EduCardBoden/GameboyPi/bestellung/Warenkoerbe.md

# Warenkörbe – Stand 11.11.2026, 21:20 (DigiKey geändert)

Direkt aus den Warenkörben ausgelesen (angemeldet als du). **Bestellt ist nichts.** Word-Fassung: `Dokumente/Emulator/GameboyPi_Warenkoerbe.docx` (erzeugt von `tools/make_cart_list.py`). Pro Shop gibt es **einen Link**, der alle Artikel zusammen öffnet.

## 1. Amazon – 7 Artikel im Warenkorb, 63,01 €

**Link:** https://www.amazon.de/gp/cart/view.html (dein Warenkorb, die Artikel liegen schon drin)

| Artikel | Wofür | Preis |
|---|---|---|
| LAFVIN 2,4" TFT ILI9341 SPI mit Touch | Display | 16,13 € |
| Verbatim Premium microSDHC 32 GB | System | 12,14 € |
| GeeekPi 220-tlg. M2,5-Set (11-mm-Bolzen) | Pi befestigen | 12,10 € |
| Ewwtrey 260-tlg. M3-Nylon-Set | Display befestigen | 7,04 € |
| Kozelo 30 × M2,5 × 20 Zylinderschrauben | Gehäuse | 4,63 € |
| BOBOZHONG Kapton-Band 10 mm × 33 m | Akku isolieren | 4,73 € |
| sourcing map Schaumband 5 mm × 1 mm | Polster Display | 6,24 € |
| **Summe Warenkorb** | | **63,01 €** |

Unter „Für später gespeichert“ (nicht in der Summe, im Warenkorb unten mit „In den Einkaufswagen“ zurückholen):

| Artikel | Preis | Hinweis |
|---|---|---|
| 2er-Set LiPo 103450 2000 mAh, JST 2,0 | 13,90 € | **derzeit nicht auf Lager** |
| Litzen-Set 0,14 mm², 10 Farben | 16,39 € | auf Lager |

Mit beiden: 93,30 €.

## 2. DigiKey – 23 Positionen, 51,84 € + 25,00 € Versand = 76,84 €

**Link (Kopie des Warenkorbs, öffnet alle 23 Teile):** https://www.digikey.at/short/f3b0w9n4
Dein eigener Warenkorb: https://www.digikey.at/ordering/shoppingcart

| Pos | Teil | Herstellernr. | Menge | Preis |
|---|---|---|---|---|
| 1 | ADS1115 ADC (Adafruit) | 1085 | 1 | 13,13 € |
| 2 | Schiebeschalter | OS102011MA1QN1 | 1 | 0,66 € |
| 3 | Klinkenbuchse 3,5 mm | SJ1-3525N | 1 | 1,08 € |
| 4 | Poti 10 k log | PTV09A-2020F-A103 | 1 | 1,08 € |
| 5 | Taster 6 × 6 × 5 | B3F-1020 | 10 | 3,20 € |
| 6 | MOSFET | BS170 | 3 | 1,20 € |
| 7 | Lautsprecher 20 mm 8 Ω | AS02008MR-5-R | 1 | 3,22 € |
| 8 | Buchsenleiste 2 × 20 | PPTC202LFBN-RC | 1 | 1,88 € |
| 9 | Stiftleiste 1 × 3 | PRPC003SAAN-RC | 1 | 0,09 € |
| 10 | Widerstand 1 k | MFR-25FBF52-1K | 2 | 0,18 € |
| 11 | Widerstand 270 Ω | MFR-25FBF52-270R | 3 | 0,27 € |
| 12 | Widerstand 150 Ω | MFR-25FBF52-150R | 3 | 0,27 € |
| 13 | Widerstand 1 M | MFR-25FBF52-1M | 2 | 0,18 € |
| 14 | PowerBoost 1000C (Adafruit) | 2465 | 1 | 17,52 € |
| 15 | PAM8302 Verstärker (Adafruit) | 2130 | 1 | 3,47 € |
| 16 | Schottky-Diode | BAT85S-TAP | 2 | 0,88 € |
| 17 | Kondensator 33 nF | K333K15X7RF5TL2 | 3 | 0,78 € |
| 18 | Kondensator 100 nF | K104K15X7RF5TL2 | 2 | 0,54 € |
| 19 | Widerstand 100 k | MFR-25FBF52-100K | 10 | 0,37 € |
| 20 | Elko 100 µF 10 V | ECE-A1AKS101 | 3 | 0,96 € |
| 21 | Elko 470 µF 10 V | 10YXJ470M6.3X11 | 1 | 0,30 € |
| 22 | LED rot 3 mm | LTL-4221N | 2 | 0,34 € |
| 23 | Widerstand 47 kΩ 5 % (R6/R7, neu) | Stackpole CF14JT47K0 | 10 | 0,24 € |
| | **Zwischensumme** | | | **51,84 €** |

- **Geändert 11.11.2026:** 10 kΩ entfernt (v1.2 braucht sie nicht mehr), 47 kΩ ergänzt. Der Yageo MFR-25FBF52-47K wäre erst ab 17.03.2027 lieferbar, deshalb der sofort lieferbare Stackpole CF14JT47K0 (5 %, 2,3 × 6,0 mm). 10 Stück (0,24 €) sind billiger als 4 (0,36 €).
- Pos. 22 (LED) hat Lieferrückstand, laut DigiKey wieder lagernd am 16.11.2026.
- Ab 75 € Warenwert ist der Versand gratis, dir fehlen 23,16 €.
- Der geteilte Link zeigt den Stand von heute. Spätere Änderungen am Warenkorb übernimmt er nicht.

## 3. JLCPCB – Platine

Nicht auslesbar: Im Browser bist du bei JLCPCB nicht angemeldet, dort steht „Shopping Cart 0“. Am 21.10. lag die Platine für **10,40 $** im Warenkorb, aber das war noch die **v1.1**.
**Link:** https://cart.jlcpcb.com/quote → `bestellung/1_platine_JLCPCB/GameboyPi_Gerber.zip` (v1.2) neu hochladen.

## Noch in keinem Warenkorb

- **Raspberry Pi Zero 2 WH**: überall knapp (siehe `documentation/PURCHASING_COMPARISON.md`)
- 3D-Druck des Gehäuses

## Gesamt (ohne Pi, Platine, 3D-Druck)

| Shop | Betrag |
|---|---|
| Amazon (Warenkorb) | 63,01 € |
| Amazon (gemerkt: Akku + Litze) | 30,29 € |
| DigiKey inkl. Versand | 76,84 € |
| **Summe** | **170,14 €** |
