EduCardBoden/GameboyPi/mechanical/previews/back_outside.png

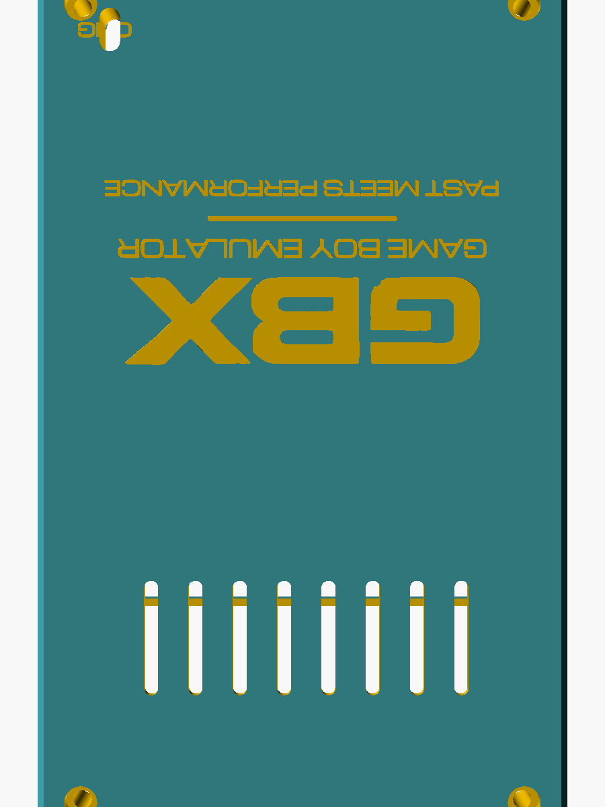
mechanical/previews/back_outside.png
