EduCardBoden/GameboyPi/electronics/assembly/GameboyPi_bom_kicad.csv

Reference | Value | Footprint | QUANTITY
C1 | 470uF 10V 10YXJ470M6.3X11 | Capacitor_THT:CP_Radial_D6.3mm_P2.50mm | 1
C2,C4 | 33nF | Capacitor_THT:C_Disc_D3.0mm_W1.6mm_P2.50mm | 2
C3,C5 | 100uF 10V ECE-A1AKS101 | Capacitor_THT:CP_Radial_D6.3mm_P2.50mm | 2
C6 | 100nF | Capacitor_THT:C_Disc_D3.0mm_W1.6mm_P2.50mm | 1
D1 | LED rot 3mm | LED_THT:LED_D3.0mm | 1
D2 | BAT85 | Diode_THT:D_DO-35_SOD27_P7.62mm_Horizontal | 1
J1 | Raspberry Pi Zero 2 W | Module:Raspberry_Pi_Zero_Socketed_THT_FaceDown_MountingHoles | 1
J2 | LCD 2.4in ILI9341 SPI (MSP2401) | Connector_PinHeader_2.54mm:PinHeader_1x14_P2.54mm_Vertical | 1
J3 | Adafruit PAM8302 | Connector_PinHeader_2.54mm:PinHeader_1x05_P2.54mm_Vertical | 1
J7 | SJ1-3525N | Connector_Audio:Jack_3.5mm_CUI_SJ1-3525N_Horizontal | 1
J8 | UART Debug (GND TX RX) | Connector_PinHeader_2.54mm:PinHeader_1x03_P2.54mm_Vertical | 1
J10 | Adafruit PowerBoost 1000C | Connector_PinHeader_2.54mm:PinHeader_1x08_P2.54mm_Vertical | 1
J11 | ADS1115 JP2 (VCC..ALERT) | Connector_PinHeader_2.54mm:PinHeader_1x06_P2.54mm_Vertical | 1
J12 | ADS1115 JP1 (AVDD..AGND) | Connector_PinHeader_2.54mm:PinHeader_1x06_P2.54mm_Vertical | 1
Q1,Q2 | BS170 | Package_TO_SOT_THT:TO-92_Inline_Wide | 2
R1 | 1k | Resistor_THT:R_Axial_DIN0207_L6.3mm_D2.5mm_P7.62mm_Horizontal | 1
R2,R4 | 270 | Resistor_THT:R_Axial_DIN0207_L6.3mm_D2.5mm_P7.62mm_Horizontal | 2
R3,R5 | 150 | Resistor_THT:R_Axial_DIN0207_L6.3mm_D2.5mm_P7.62mm_Horizontal | 2
R6,R7 | 47k | Resistor_THT:R_Axial_DIN0207_L6.3mm_D2.5mm_P7.62mm_Horizontal | 2
R8 | 1M | Resistor_THT:R_Axial_DIN0207_L6.3mm_D2.5mm_P7.62mm_Horizontal | 1
R9-R12 | 100k | Resistor_THT:R_Axial_DIN0207_L6.3mm_D2.5mm_P7.62mm_Horizontal | 4
RV1 | PTV09A-2020F-A103 10k log | Potentiometer_THT:Potentiometer_Bourns_PTV09A-2_Single_Horizontal | 1
SW1 | UP | Button_Switch_THT:SW_PUSH_6mm | 1
SW2 | DOWN | Button_Switch_THT:SW_PUSH_6mm | 1
SW3 | LEFT | Button_Switch_THT:SW_PUSH_6mm | 1
SW4 | RIGHT | Button_Switch_THT:SW_PUSH_6mm | 1
SW5 | A | Button_Switch_THT:SW_PUSH_6mm | 1
SW6 | B | Button_Switch_THT:SW_PUSH_6mm | 1
SW7 | SELECT | Button_Switch_THT:SW_PUSH_6mm | 1
SW8 | START | Button_Switch_THT:SW_PUSH_6mm | 1
SW9 | POWER | Button_Switch_THT:SW_Slide_SPDT_Angled_CK_OS102011MA1Q | 1
TP1 | VBAT | TestPoint:TestPoint_THTPad_D1.5mm_Drill0.7mm | 1
TP2 | +5V | TestPoint:TestPoint_THTPad_D1.5mm_Drill0.7mm | 1
TP3 | +3V3 | TestPoint:TestPoint_THTPad_D1.5mm_Drill0.7mm | 1
TP4 | GND | TestPoint:TestPoint_THTPad_D1.5mm_Drill0.7mm | 1
TP5 | PB_EN | TestPoint:TestPoint_THTPad_D1.5mm_Drill0.7mm | 1
TP6 | AMP_IN | TestPoint:TestPoint_THTPad_D1.5mm_Drill0.7mm | 1
