EduCardBoden/GameboyPi/bestellung/3_3d_druck/startselect.stl

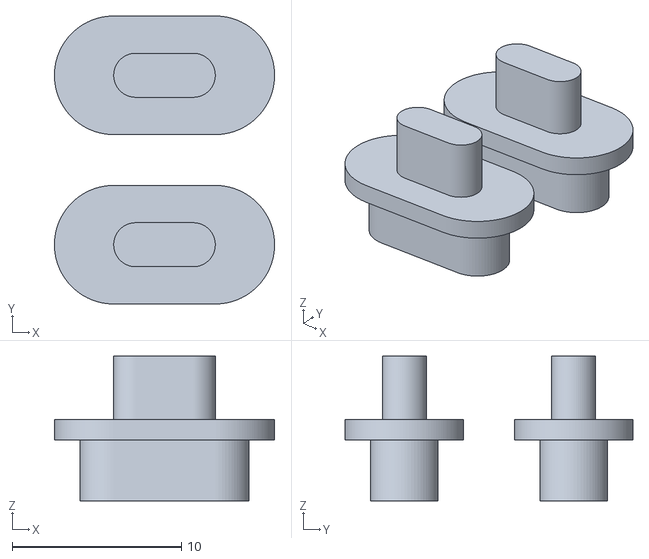
[picture p9: CAD file, 2026-10-29]
bestellung/3_3d_druck/startselect.stl
13.0 x 17.0 x 8.53
