EduCardBoden/GameboyPi/electronics/assembly/GameboyPi.step

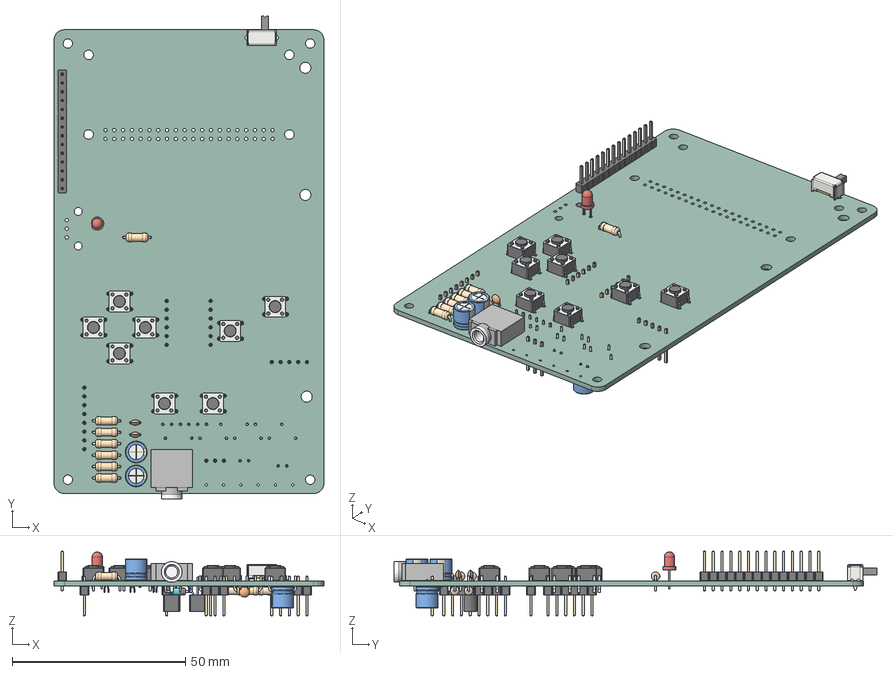
[picture p10: CAD file, 2026-11-11]
electronics/assembly/GameboyPi.step
78.0 x 139.4 x 18.8 mm
SW_PUSH_6mm x 8
R_Axial_DIN0207_L63mm_D25mm_P762mm_Horizontal x 12
Jack_3.5mm_CUI_SJ1-3525N_Horizontal
LED_D3.0mm
CP_Radial_D63mm_P250mm x 3
C_Disc_D30mm_W16mm_P250mm x 3
PinHeader_1x14_P254mm_Vertical
SW_Slide_SPDT_Angled_CK_OS102011MA1Q
PinHeader_1x06_P254mm_Vertical x 2
D_DO-35_SOD27_P7.62mm_Horizontal
PinHeader_1x08_P254mm_Vertical
PinHeader_1x03_P254mm_Vertical
TO-92_Inline_Wide x 2
PinHeader_1x05_P254mm_Vertical
GameboyPi_PCB
