EduCardBoden/GameboyPi/mechanical/stl/back_logo_silver.stl

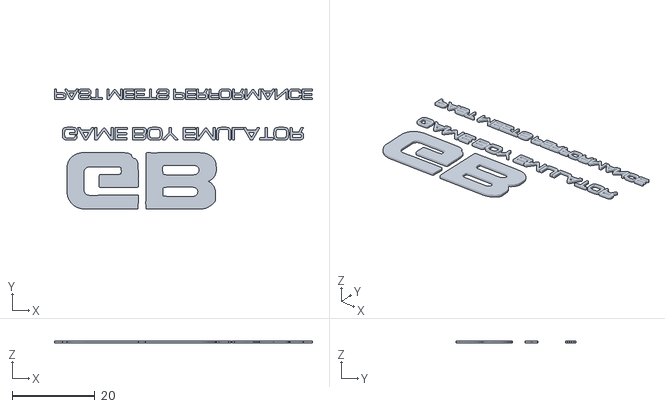
[picture p11: CAD file, 2026-10-29]
mechanical/stl/back_logo_silver.stl
62.2 x 29.0 x 0.6
