EduCardBoden/GameboyPi/mechanical/stl/front_logo_silver.stl

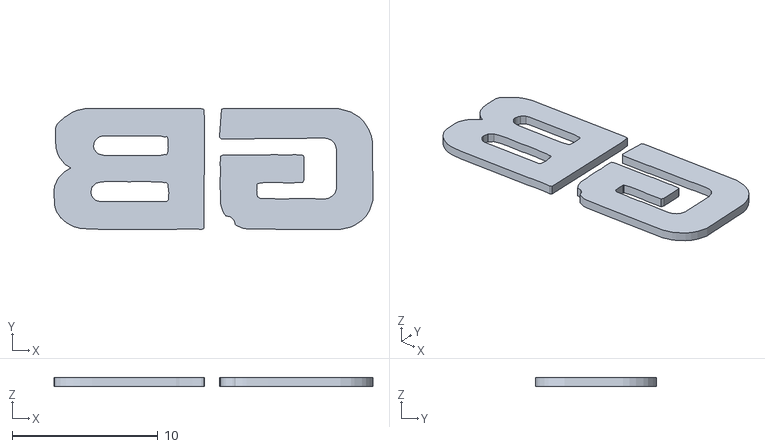
[picture p12: CAD file, 2026-10-29]
mechanical/stl/front_logo_silver.stl
21.9 x 8.30 x 0.6
