EduCardBoden/GameboyPi/bestellung/3_3d_druck/knob.stl

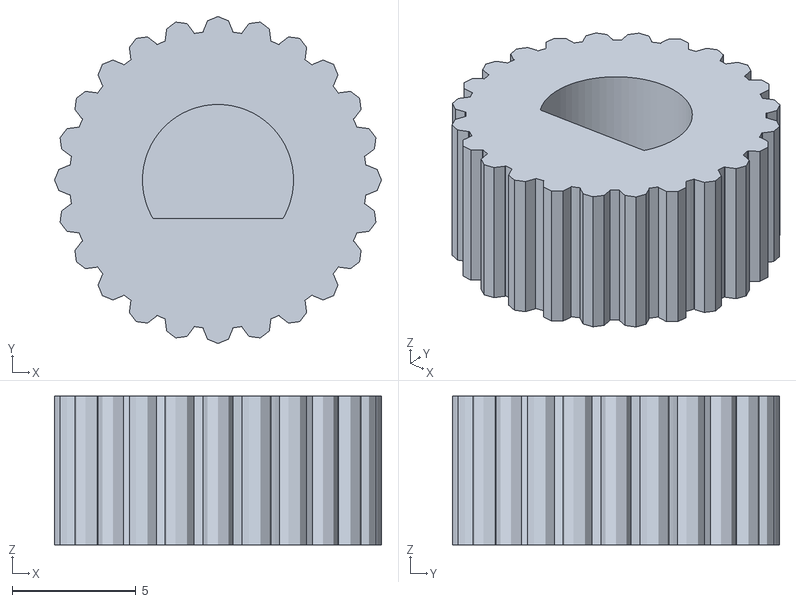
[picture p13: CAD file, 2026-10-29]
bestellung/3_3d_druck/knob.stl
13.2 x 13.2 x 6.00
