EduCardBoden/GameboyPi/bestellung/3_3d_druck/front_logo_purple.stl

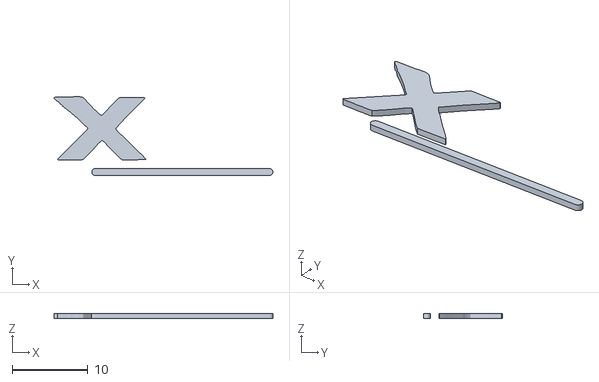
[picture p14: CAD file, 2026-10-29]
bestellung/3_3d_druck/front_logo_purple.stl
29.0 x 10.4 x 0.6
