EduCardBoden/GameboyPi/mechanical/stl/spacers.stl

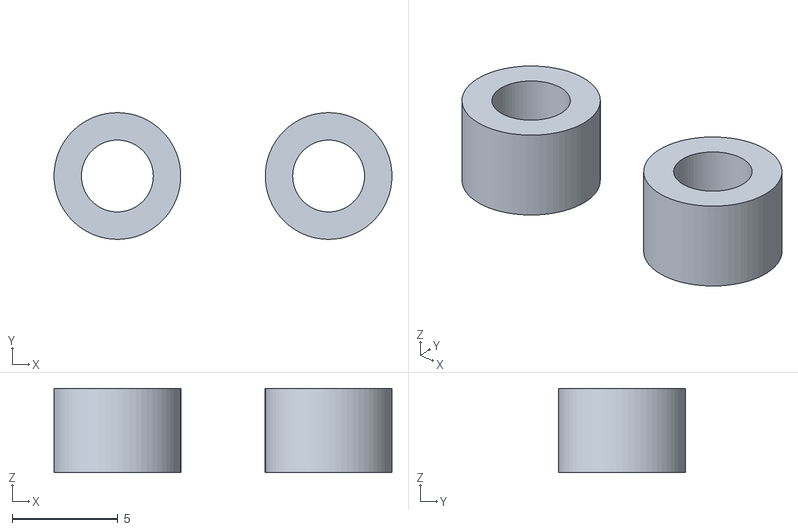
[picture p15: CAD file, 2026-10-29]
mechanical/stl/spacers.stl
16.0 x 6.00 x 4.00
