EduCardBoden/GameboyPi/bestellung/3_3d_druck/back_logo_purple.stl

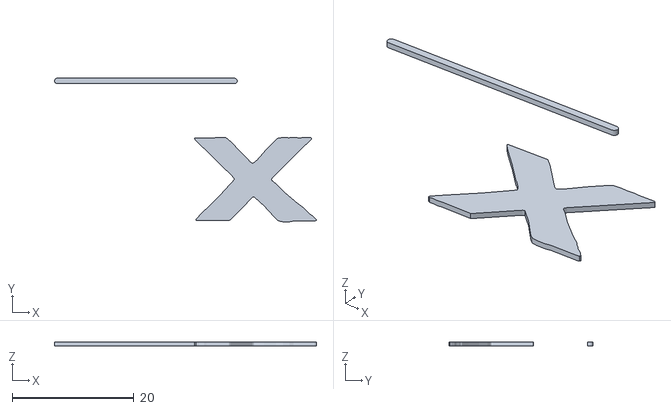
[picture p16: CAD file, 2026-10-29]
bestellung/3_3d_druck/back_logo_purple.stl
43.0 x 23.6 x 0.6
