EduCardBoden/GameboyPi/mechanical/stl/dpad.stl

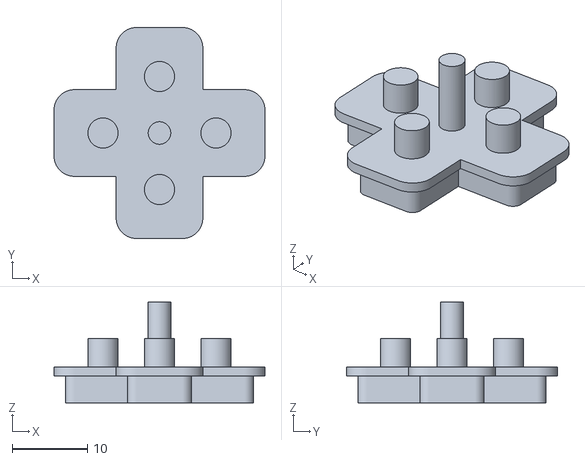
[picture p17: CAD file, 2026-10-29]
mechanical/stl/dpad.stl
28.0 x 28.0 x 13.4
