EduCardBoden/GameboyPi/bestellung/3_3d_druck/front.stl

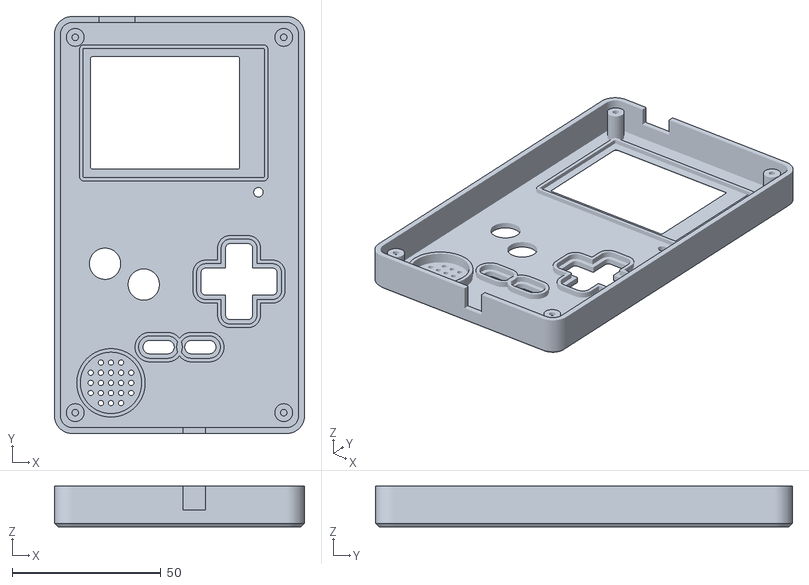
[picture p18: CAD file, 2026-10-29]
bestellung/3_3d_druck/front.stl
84.0 x 140.0 x 13.7
