EduCardBoden/GameboyPi/mechanical/stl/ab.stl

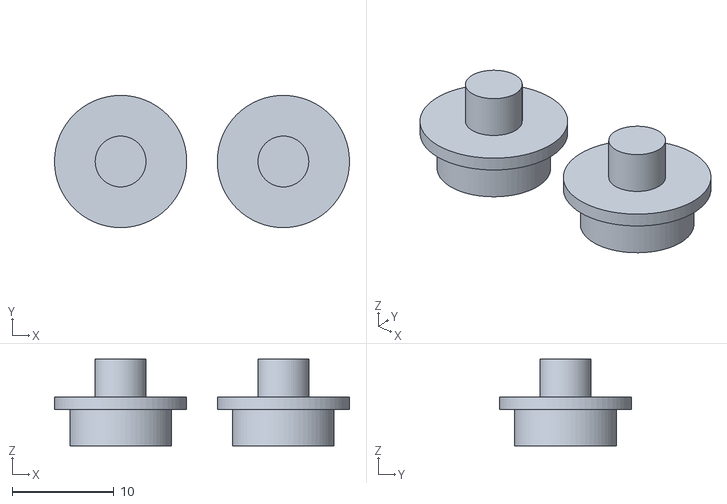
[picture p19: CAD file, 2026-10-29]
mechanical/stl/ab.stl
29.0 x 13.0 x 8.53
