EduCardBoden/GameboyPi/bestellung/3_3d_druck/back.stl

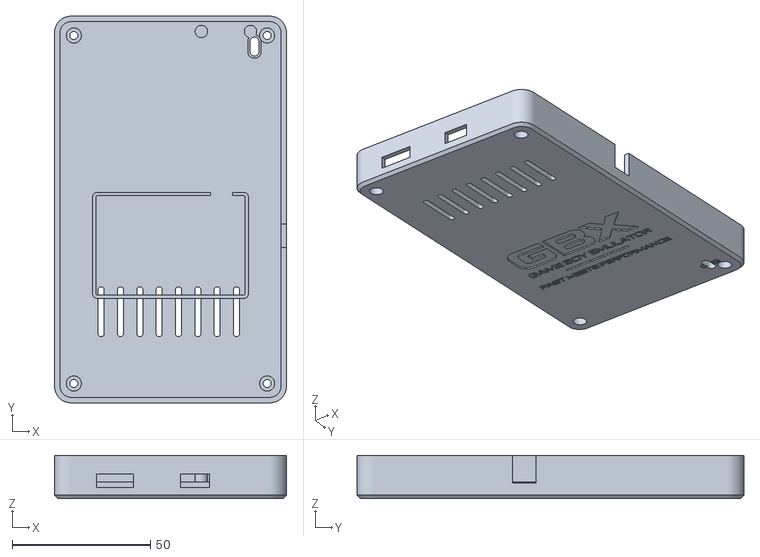
[picture p20: CAD file, 2026-10-29]
bestellung/3_3d_druck/back.stl
84.0 x 140.0 x 15.6
