EduCardBoden/GameboyPi/mechanical/cad-source/logo/gbx_logo.scad

// automatisch erzeugt von trace_logo.py aus gbx_logo_source.jpeg – nicht von Hand bearbeiten
// Logo-Einheiten: Breite GBX = 100, Ursprung Mitte. Höhe = 24.62
gbx_logo_height = 24.622;
module gbx_gb() {
  polygon(points=[[-28.942,-12.331],[-43.521,-12.356],[-45.572,-11.891],[-46.328,-11.525],[-47.840,-10.523],[-48.644,-9.719],[-49.372,-8.531],[-50.045,-6.479],[-49.945,5.292],[-49.695,6.587],[-49.136,7.937],[-48.164,9.426],[-47.300,10.307],[-45.572,11.351],[-43.089,12.040],[-19.870,12.041],[-19.438,11.892],[-19.062,6.911],[-19.071,6.263],[-19.330,5.928],[-25.702,5.886],[-26.350,5.992],[-36.393,5.994],[-37.041,6.100],[-40.173,6.100],[-40.929,5.959],[-41.685,5.637],[-42.165,5.184],[-42.461,4.644],[-42.709,3.564],[-42.701,-3.996],[-42.412,-4.968],[-41.845,-5.616],[-41.037,-6.066],[-40.389,-6.200],[-33.585,-6.102],[-32.829,-6.208],[-30.454,-6.209],[-29.806,-6.103],[-27.322,-6.100],[-27.087,-6.048],[-26.674,-5.699],[-26.558,-4.428],[-26.638,-3.240],[-26.782,-3.096],[-28.294,-2.863],[-31.425,-2.863],[-32.073,-2.970],[-35.867,-2.916],[-36.122,-2.376],[-36.122,2.268],[-35.961,2.600],[-34.125,2.752],[-33.153,2.647],[-29.590,2.754],[-28.834,2.646],[-19.762,2.644],[-19.222,2.447],[-19.170,0.756],[-19.276,-1.188],[-19.170,-1.836],[-19.169,-4.320],[-19.275,-4.968],[-19.278,-7.343],[-19.634,-8.531],[-19.957,-9.179],[-20.302,-9.645],[-21.166,-9.809],[-21.652,-10.151],[-22.030,-10.649],[-22.246,-11.458],[-23.650,-12.114],[-24.514,-12.256],[-28.942,-12.331],[6.695,-12.331],[-10.259,-12.365],[-10.907,-12.258],[-13.607,-12.257],[-15.443,-12.365],[-15.875,-12.216],[-16.037,9.719],[-15.858,11.879],[-15.335,12.041],[8.099,12.032],[9.719,11.682],[10.583,11.353],[12.450,10.151],[13.807,8.855],[14.083,8.099],[14.091,5.508],[13.975,3.996],[13.626,2.808],[13.283,2.129],[12.143,0.756],[11.094,0.108],[11.094,-0.000],[12.342,-0.756],[13.223,-1.620],[13.628,-2.160],[14.274,-3.564],[14.398,-4.536],[14.307,-7.451],[14.060,-8.315],[13.845,-8.855],[13.067,-9.987],[12.018,-10.907],[11.123,-11.469],[10.475,-11.790],[9.179,-12.140],[6.695,-12.331],[4.266,2.592],[5.508,2.895],[6.282,3.780],[6.415,4.428],[6.282,5.184],[5.987,5.724],[5.184,6.390],[4.320,6.533],[-6.911,6.532],[-7.883,6.327],[-8.423,6.367],[-8.574,6.156],[-8.684,4.212],[-8.551,3.024],[-8.315,2.704],[-7.883,2.744],[-6.803,2.538],[4.266,2.592],[5.238,-6.695],[5.940,-6.501],[6.587,-5.884],[6.822,-5.508],[6.956,-4.860],[6.717,-3.780],[5.832,-3.005],[4.752,-2.763],[2.808,-2.647],[-1.080,-2.754],[-1.836,-2.647],[-4.644,-2.646],[-5.292,-2.752],[-7.127,-2.763],[-7.991,-2.950],[-8.315,-2.883],[-8.575,-3.132],[-8.800,-4.968],[-8.678,-6.479],[-8.423,-6.714],[5.238,-6.695]],
          paths=[[0, 1, 2, 3, 4, 5, 6, 7, 8, 9, 10, 11, 12, 13, 14, 15, 16, 17, 18, 19, 20, 21, 22, 23, 24, 25, 26, 27, 28, 29, 30, 31, 32, 33, 34, 35, 36, 37, 38, 39, 40, 41, 42, 43, 44, 45, 46, 47, 48, 49, 50, 51, 52, 53, 54, 55, 56, 57, 58, 59, 60, 61, 62, 63, 64, 65, 66, 67, 68, 69, 70, 71, 72, 73], [74, 75, 76, 77, 78, 79, 80, 81, 82, 83, 84, 85, 86, 87, 88, 89, 90, 91, 92, 93, 94, 95, 96, 97, 98, 99, 100, 101, 102, 103, 104, 105, 106, 107, 108, 109], [110, 111, 112, 113, 114, 115, 116, 117, 118, 119, 120, 121, 122, 123, 124, 125, 126, 127], [128, 129, 130, 131, 132, 133, 134, 135, 136, 137, 138, 139, 140, 141, 142, 143, 144, 145, 146, 147, 148]]);
}
module gbx_x() {
  polygon(points=[[48.380,-12.317],[44.600,-12.257],[43.844,-12.363],[41.793,-12.257],[40.605,-12.346],[38.769,-12.215],[38.069,-11.663],[35.483,-9.071],[32.613,-5.780],[31.317,-4.719],[30.562,-5.246],[25.000,-11.015],[23.474,-12.311],[14.261,-12.203],[14.223,-11.987],[14.471,-11.667],[15.829,-10.259],[19.490,-6.803],[23.542,-2.714],[23.974,-2.428],[25.100,-1.296],[25.985,-0.108],[21.644,4.644],[15.767,10.423],[14.644,11.663],[14.613,11.879],[14.903,12.021],[15.443,11.933],[16.955,12.041],[17.819,11.933],[24.406,12.006],[24.838,11.717],[31.265,5.184],[31.641,4.999],[34.557,7.621],[38.121,11.499],[38.877,12.115],[40.173,12.356],[42.117,12.365],[43.197,12.151],[49.460,12.148],[49.892,12.004],[49.994,11.771],[49.028,10.751],[48.164,10.196],[47.300,9.301],[46.868,9.014],[46.652,8.616],[44.060,6.635],[40.497,3.612],[37.957,1.080],[36.989,0.324],[36.792,-0.000],[37.095,-0.540],[48.512,-11.879],[48.622,-12.095],[48.380,-12.317]],
          paths=[[0, 1, 2, 3, 4, 5, 6, 7, 8, 9, 10, 11, 12, 13, 14, 15, 16, 17, 18, 19, 20, 21, 22, 23, 24, 25, 26, 27, 28, 29, 30, 31, 32, 33, 34, 35, 36, 37, 38, 39, 40, 41, 42, 43, 44, 45, 46, 47, 48, 49, 50, 51, 52, 53, 54, 55, 56]]);
}
module gbx_logo() { gbx_gb(); gbx_x(); }
