EduCardBoden/GameboyPi/electronics/assembly/Bestueckung_hinten.pdf

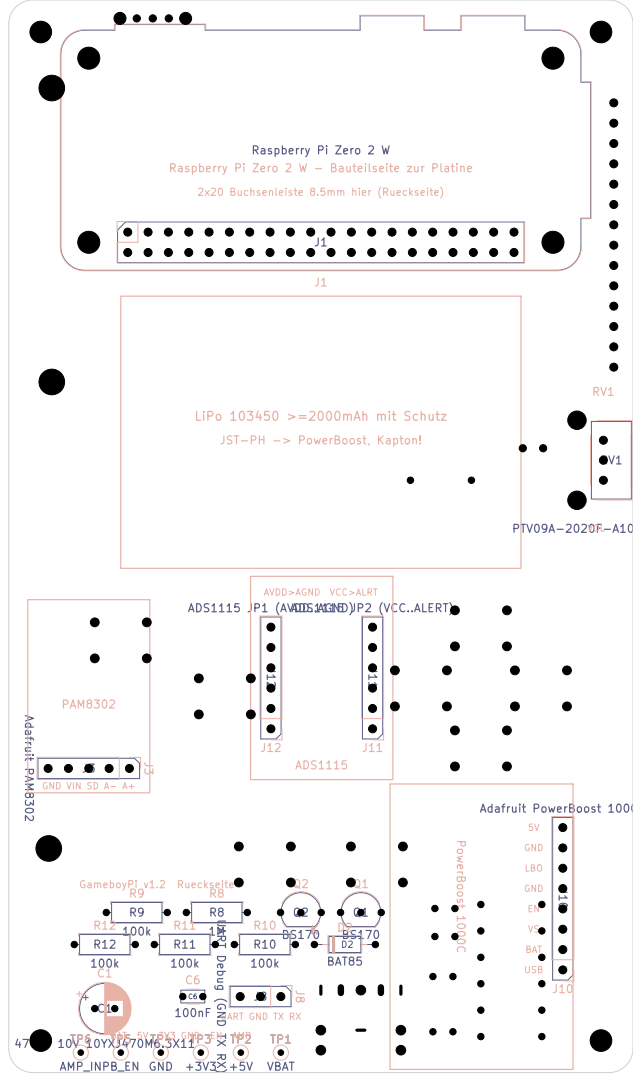
[picture p21: page 1]

Raspberry Pi Zero 2 W - Bauteilseite zur Platine

AVDD>AGND VCC>ALRT UART GND TX RX BAT 5V 3V3 GND EN AMP

GND VIN SD A- A+ | Adafruit PowerBoost 1000C J10
