EduCardBoden/GameboyPi/electronics/schematics/GameboyPi_Schaltplan.pdf

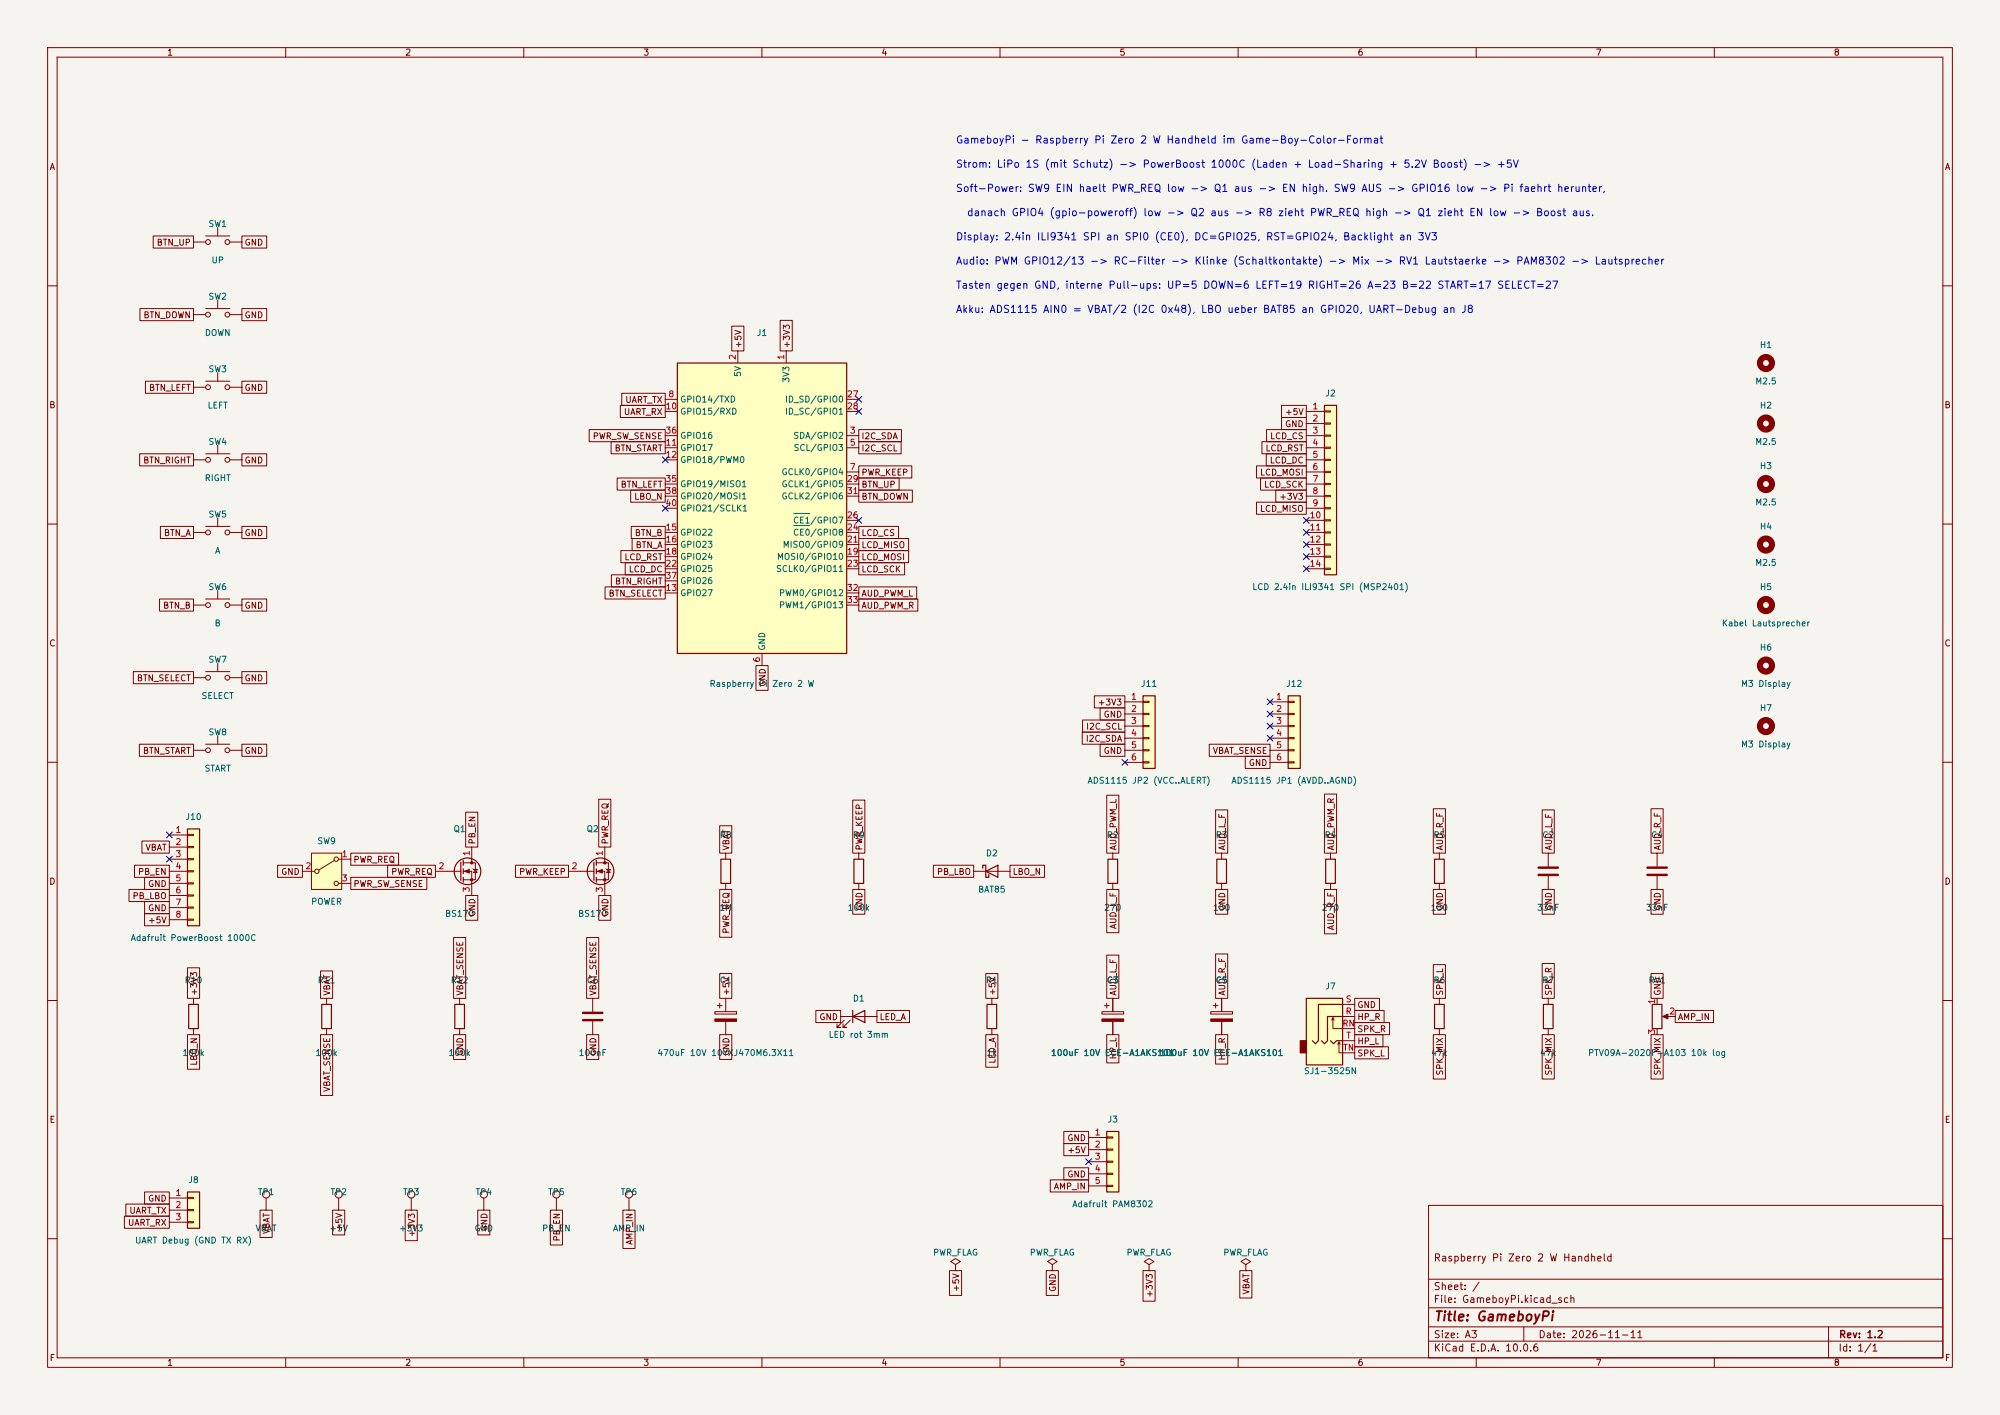
[picture p22: page 1]

GameboyPi - Raspberry Pi Zero 2 W Handheld im Game-Boy-Color-Format

Strom: LiPo 1S (mit Schutz) -> PowerBoost 1000C (Laden + Load-Sharing + 5.2V Boost) -> +5V

Soft-Power: SW9 EIN haelt PWR_REQ low -> Q1 aus -> EN high. SW9 AUS -> GPIO16 low -> Pi faehrt herunter,

danach GPIO4 (gpio-poweroff) low -> Q2 aus -> R8 zieht PWR_REQ high -> Q1 zieht EN low -> Boost aus. Display: 2.4in ILI9341 SPI an SPI0 (CE0), DC=GPIO25, RST=GPIO24, Backlight an 3V3

Audio: PWM GPIO12/13 -> RC-Filter -> Klinke (Schaltkontakte) -> Mix -> RV1 Lautstaerke -> PAM8302 -> Lautsprecher

Tasten gegen GND, interne Pull-ups: UP=5 DOWN=6 LEFT=19 RIGHT=26 A=23 B=22 START=17 SELECT=27

Akku: ADS1115 AIN0 = VBAT/2 (I2C 0x48), LBO ueber BAT85 an GPIO20, UART-Debug an J8

J8 UART Debug (GND TX RX)

Raspberry Pi Zero 2 W Handheld

Size: A3 | Rev: 1.2 | F Date: 2026-11-11
KiCad E.D.A. 10.0.6 | Id: 1/1
