EduCardBoden/GameboyPi/electronics/assembly/Bestueckung_vorne.pdf

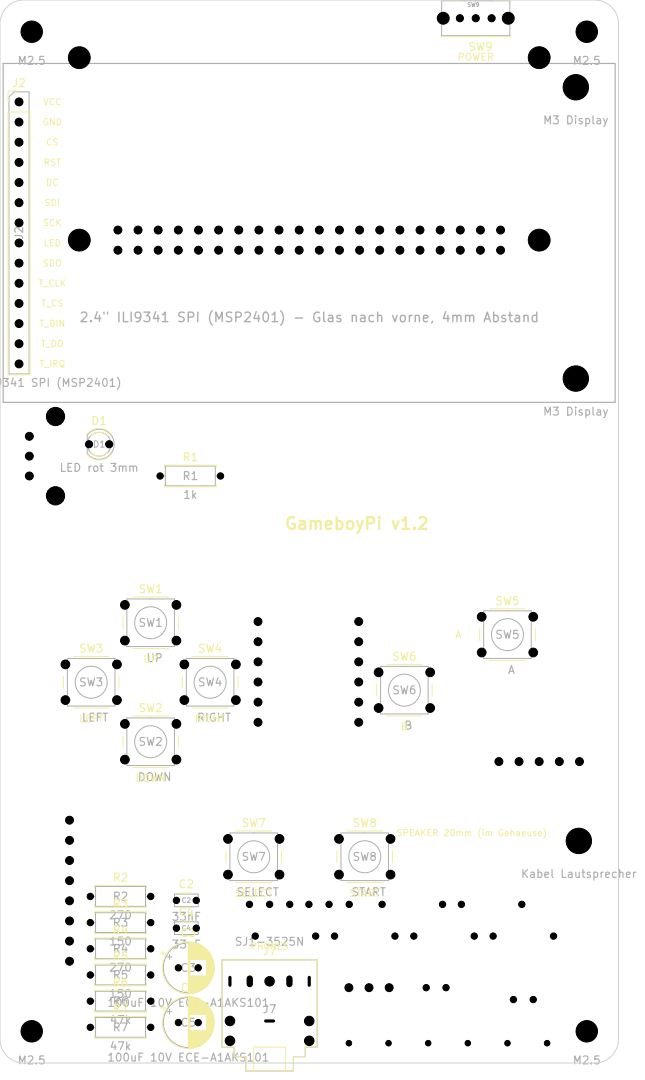
[picture p23: page 1]
