EduCardBoden/GameboyPi/electronics/kicad-project/GameboyPi.kicad_pcb

## KiCad design electronics/kicad-project/GameboyPi.kicad_pcb (2026-11-11)

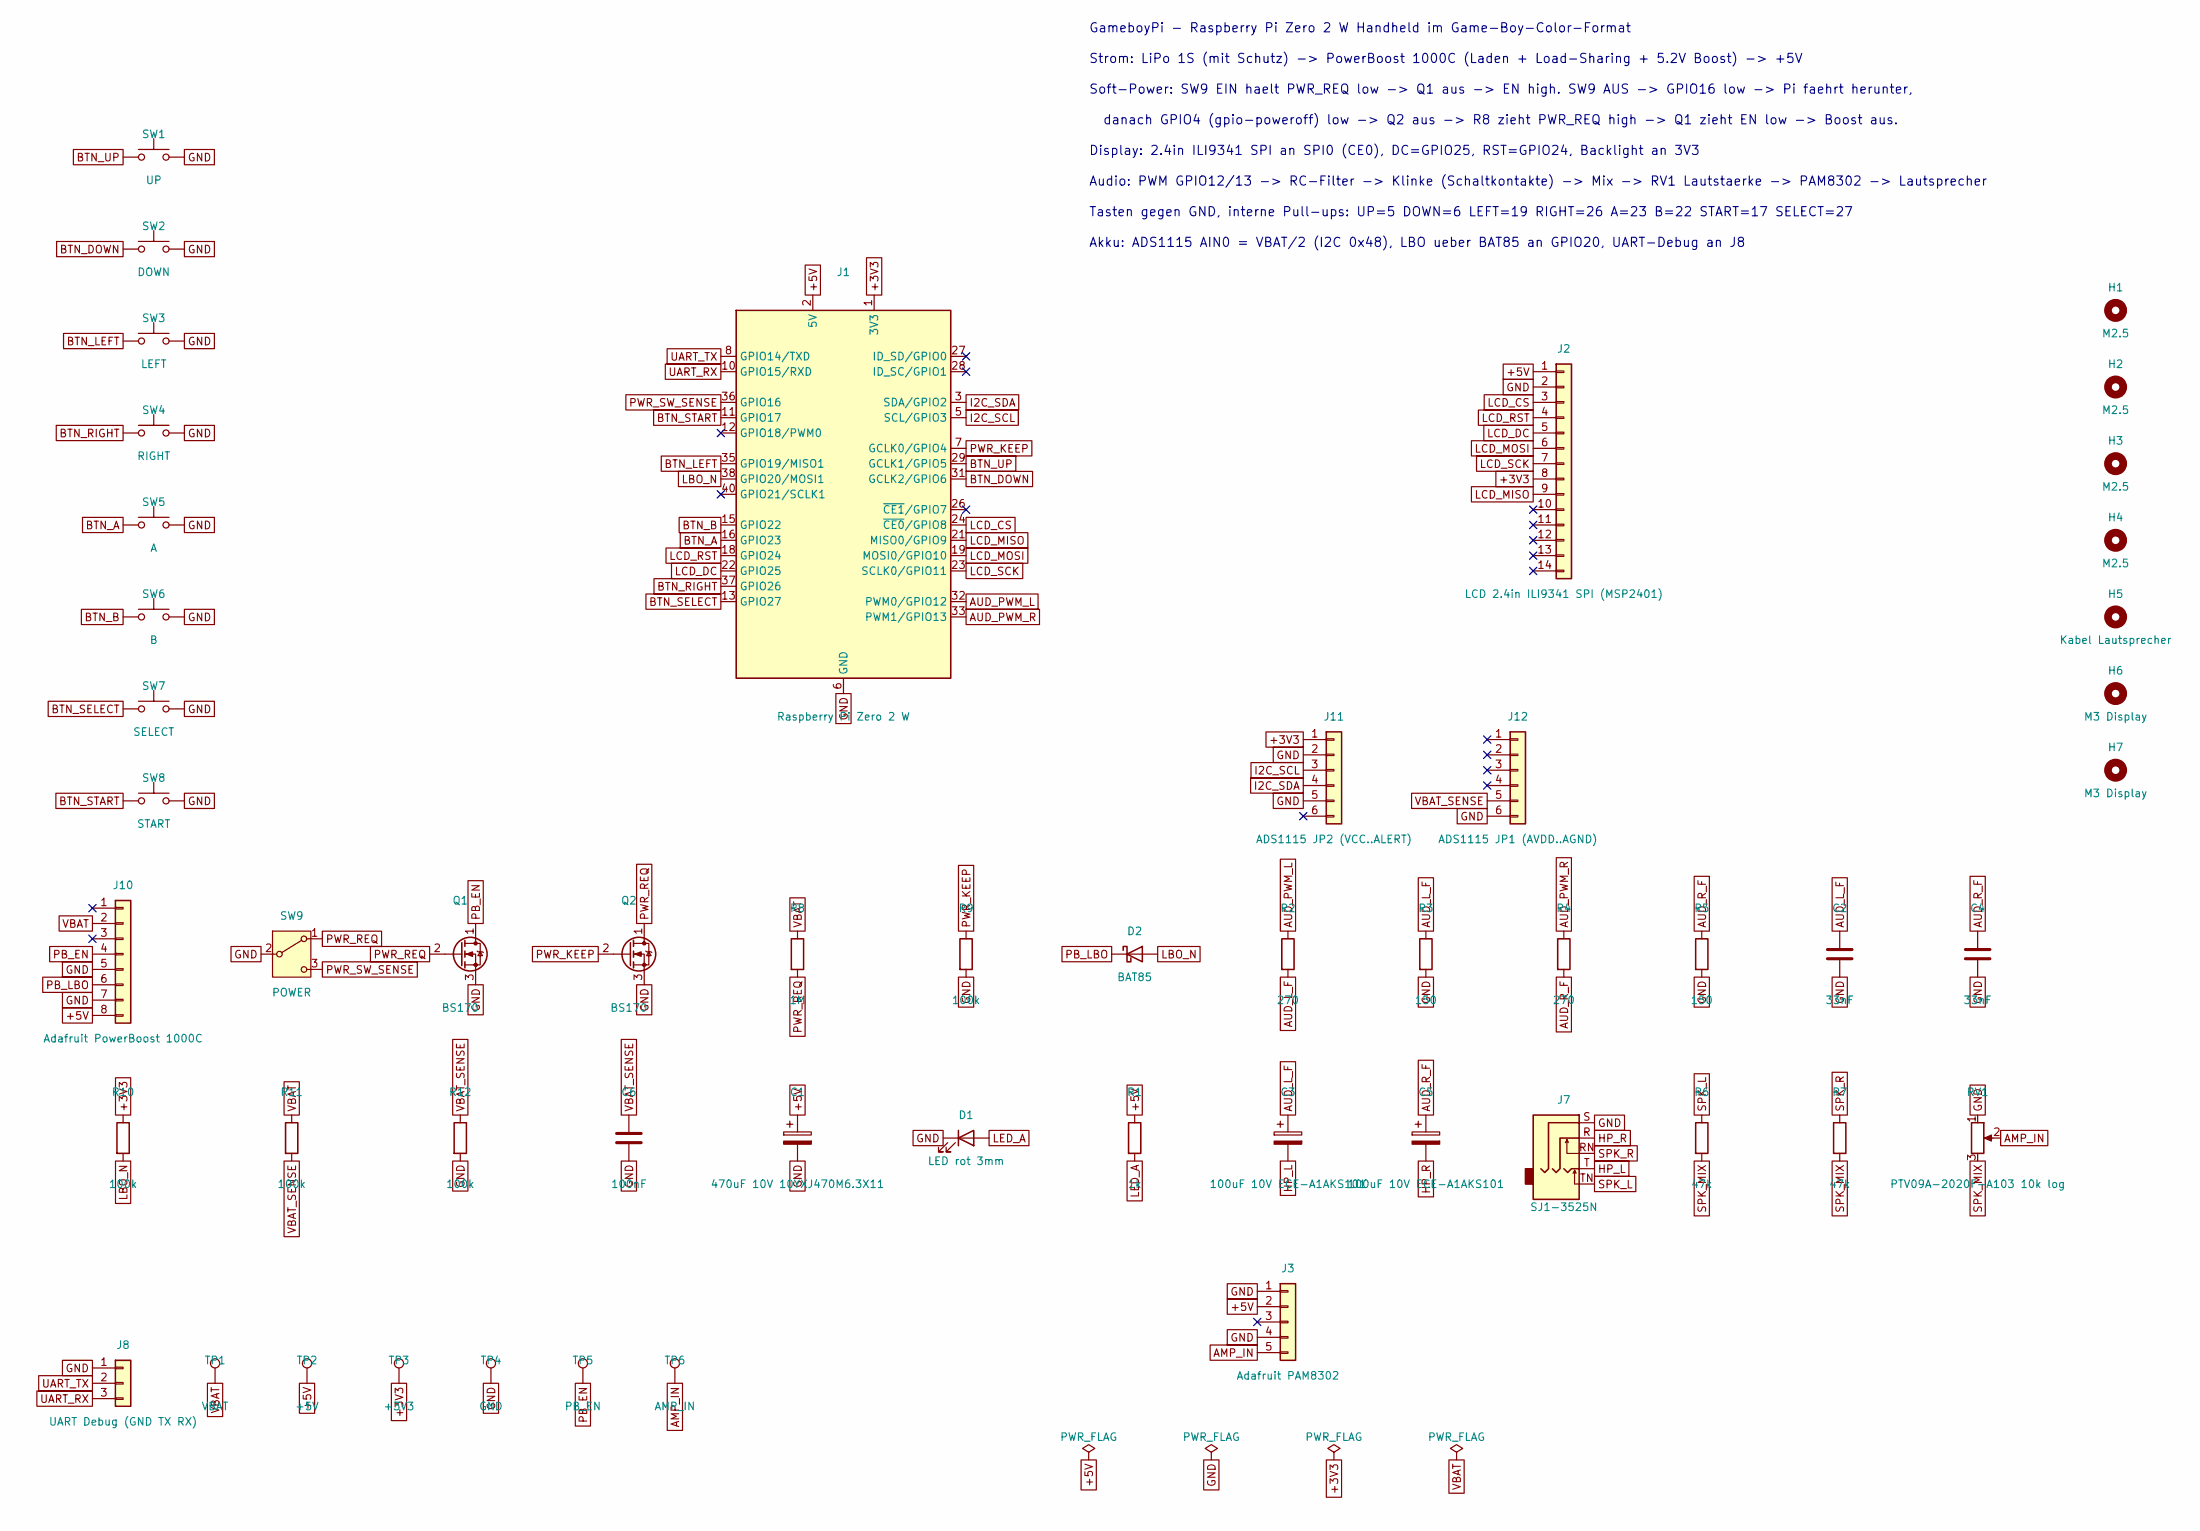
[picture p24: schematic GameboyPi.kicad_sch]

Parts:
C1: 470uF 10V 10YXJ470M6.3X11; CP_Radial_D6.3mm_P2.50mm
C2, C4: 33nF; C_Disc_D3.0mm_W1.6mm_P2.50mm
C3, C5: 100uF 10V ECE-A1AKS101; CP_Radial_D6.3mm_P2.50mm
C6: 100nF; C_Disc_D3.0mm_W1.6mm_P2.50mm
D1: LED rot 3mm; LED_D3.0mm
D2: BAT85; D_DO-35_SOD27_P7.62mm_Horizontal
H1, H2, H3, H4: M2.5; MountingHole_2.7mm_M2.5
H5: Kabel Lautsprecher; MountingHole_3.2mm_M3
H6, H7: M3 Display; MountingHole_3.2mm_M3
J1: Raspberry Pi Zero 2 W; Raspberry_Pi_Zero_Socketed_THT_FaceDown_MountingHoles
J2: LCD 2.4in ILI9341 SPI (MSP2401); PinHeader_1x14_P2.54mm_Vertical
J3: Adafruit PAM8302; PinHeader_1x05_P2.54mm_Vertical
J7: SJ1-3525N; Jack_3.5mm_CUI_SJ1-3525N_Horizontal
J8: UART Debug (GND TX RX); PinHeader_1x03_P2.54mm_Vertical
J10: Adafruit PowerBoost 1000C; PinHeader_1x08_P2.54mm_Vertical
J11: ADS1115 JP2 (VCC..ALERT); PinHeader_1x06_P2.54mm_Vertical
J12: ADS1115 JP1 (AVDD..AGND); PinHeader_1x06_P2.54mm_Vertical
Q1, Q2: BS170; TO-92_Inline_Wide
R1: 1k; R_Axial_DIN0207_L6.3mm_D2.5mm_P7.62mm_Horizontal
R2, R4: 270; R_Axial_DIN0207_L6.3mm_D2.5mm_P7.62mm_Horizontal
R3, R5: 150; R_Axial_DIN0207_L6.3mm_D2.5mm_P7.62mm_Horizontal
R6, R7: 47k; R_Axial_DIN0207_L6.3mm_D2.5mm_P7.62mm_Horizontal
R8: 1M; R_Axial_DIN0207_L6.3mm_D2.5mm_P7.62mm_Horizontal
R9, R10, R11, R12: 100k; R_Axial_DIN0207_L6.3mm_D2.5mm_P7.62mm_Horizontal
RV1: PTV09A-2020F-A103 10k log; Potentiometer_Bourns_PTV09A-2_Single_Horizontal
SW1: UP; SW_PUSH_6mm
SW2: DOWN; SW_PUSH_6mm
SW3: LEFT; SW_PUSH_6mm
SW4: RIGHT; SW_PUSH_6mm
SW5: A; SW_PUSH_6mm
SW6: B; SW_PUSH_6mm
SW7: SELECT; SW_PUSH_6mm
SW8: START; SW_PUSH_6mm
SW9: POWER; SW_Slide_SPDT_Angled_CK_OS102011MA1Q
TP1: VBAT; TestPoint_THTPad_D1.5mm_Drill0.7mm
TP2: +5V; TestPoint_THTPad_D1.5mm_Drill0.7mm
TP3: +3V3; TestPoint_THTPad_D1.5mm_Drill0.7mm
TP4: GND; TestPoint_THTPad_D1.5mm_Drill0.7mm
TP5: PB_EN; TestPoint_THTPad_D1.5mm_Drill0.7mm
TP6: AMP_IN; TestPoint_THTPad_D1.5mm_Drill0.7mm

Connections:
+3V3: J1.1 (3V3), J1.17 (3V3), J2.8, J11.1, R10.1, TP3.1
+5V: C1.1, J1.2 (5V), J1.4 (5V), J2.1, J3.2, J10.8, R1.1, TP2.1
AMP_IN: J3.5, RV1.2, TP6.1
AUD_L_F: C2.1, C3.1, R2.2, R3.1
AUD_PWM_L: J1.32 (PWM0/GPIO12), R2.1
AUD_PWM_R: J1.33 (PWM1/GPIO13), R4.1
AUD_R_F: C4.1, C5.1, R4.2, R5.1
BTN_A: J1.16 (GPIO23), SW5.1
BTN_B: J1.15 (GPIO22), SW6.1
BTN_DOWN: J1.31 (GCLK2/GPIO6), SW2.1
BTN_LEFT: J1.35 (GPIO19/MISO1), SW3.1
BTN_RIGHT: J1.37 (GPIO26), SW4.1
BTN_SELECT: J1.13 (GPIO27), SW7.1
BTN_START: J1.11 (GPIO17), SW8.1
BTN_UP: J1.29 (GCLK1/GPIO5), SW1.1
GND: C1.2, C2.2, C4.2, C6.2, D1.1 (K), J1.6 (GND), J1.9 (GND), J1.14 (GND), J1.20 (GND), J1.25 (GND), J1.30 (GND), J1.34 (GND), J1.39 (GND), J2.2, J3.1, J3.4, J7.S, J8.1, J10.5, J10.7, J11.2, J11.5, J12.6, Q1.3 (S), Q2.3 (S), R3.2, R5.2, R9.2, R12.2, RV1.1, SW1.2, SW2.2, SW3.2, SW4.2, SW5.2, SW6.2, SW7.2, SW8.2, SW9.2 (B), TP4.1
HP_L: C3.2, J7.T
HP_R: C5.2, J7.R
I2C_SCL: J1.5 (SCL/GPIO3), J11.3
I2C_SDA: J1.3 (SDA/GPIO2), J11.4
LBO_N: D2.2 (A), J1.38 (GPIO20/MOSI1), R10.2
LCD_CS: J1.24 (~CE0/GPIO8), J2.3
LCD_DC: J1.22 (GPIO25), J2.5
LCD_MISO: J1.21 (MISO0/GPIO9), J2.9
LCD_MOSI: J1.19 (MOSI0/GPIO10), J2.6
LCD_RST: J1.18 (GPIO24), J2.4
LCD_SCK: J1.23 (SCLK0/GPIO11), J2.7
LED_A: D1.2 (A), R1.2
PB_EN: J10.4, Q1.1 (D), TP5.1
PB_LBO: D2.1 (K), J10.6
PWR_KEEP: J1.7 (GCLK0/GPIO4), Q2.2 (G), R9.1
PWR_REQ: Q1.2 (G), Q2.1 (D), R8.2, SW9.1 (A)
PWR_SW_SENSE: J1.36 (GPIO16), SW9.3 (C)
SPK_L: J7.TN, R6.1
SPK_MIX: R6.2, R7.2, RV1.3
SPK_R: J7.RN, R7.1
UART_RX: J1.10 (GPIO15/RXD), J8.3
UART_TX: J1.8 (GPIO14/TXD), J8.2
VBAT: J10.2, R8.1, R11.1, TP1.1
VBAT_SENSE: C6.1, J12.5, R11.2, R12.1

Notes on the sheet:
GameboyPi - Raspberry Pi Zero 2 W Handheld im Game-Boy-Color-Format
Strom: LiPo 1S (mit Schutz) -> PowerBoost 1000C (Laden + Load-Sharing + 5.2V Boost) -> +5V
Soft-Power: SW9 EIN haelt PWR_REQ low -> Q1 aus -> EN high. SW9 AUS -> GPIO16 low -> Pi faehrt herunter,
danach GPIO4 (gpio-poweroff) low -> Q2 aus -> R8 zieht PWR_REQ high -> Q1 zieht EN low -> Boost aus.
Display: 2.4in ILI9341 SPI an SPI0 (CE0), DC=GPIO25, RST=GPIO24, Backlight an 3V3
Audio: PWM GPIO12/13 -> RC-Filter -> Klinke (Schaltkontakte) -> Mix -> RV1 Lautstaerke -> PAM8302 -> Lautsprecher
Tasten gegen GND, interne Pull-ups: UP=5 DOWN=6 LEFT=19 RIGHT=26 A=23 B=22 START=17 SELECT=27
Akku: ADS1115 AIN0 = VBAT/2 (I2C 0x48), LBO ueber BAT85 an GPIO20, UART-Debug an J8

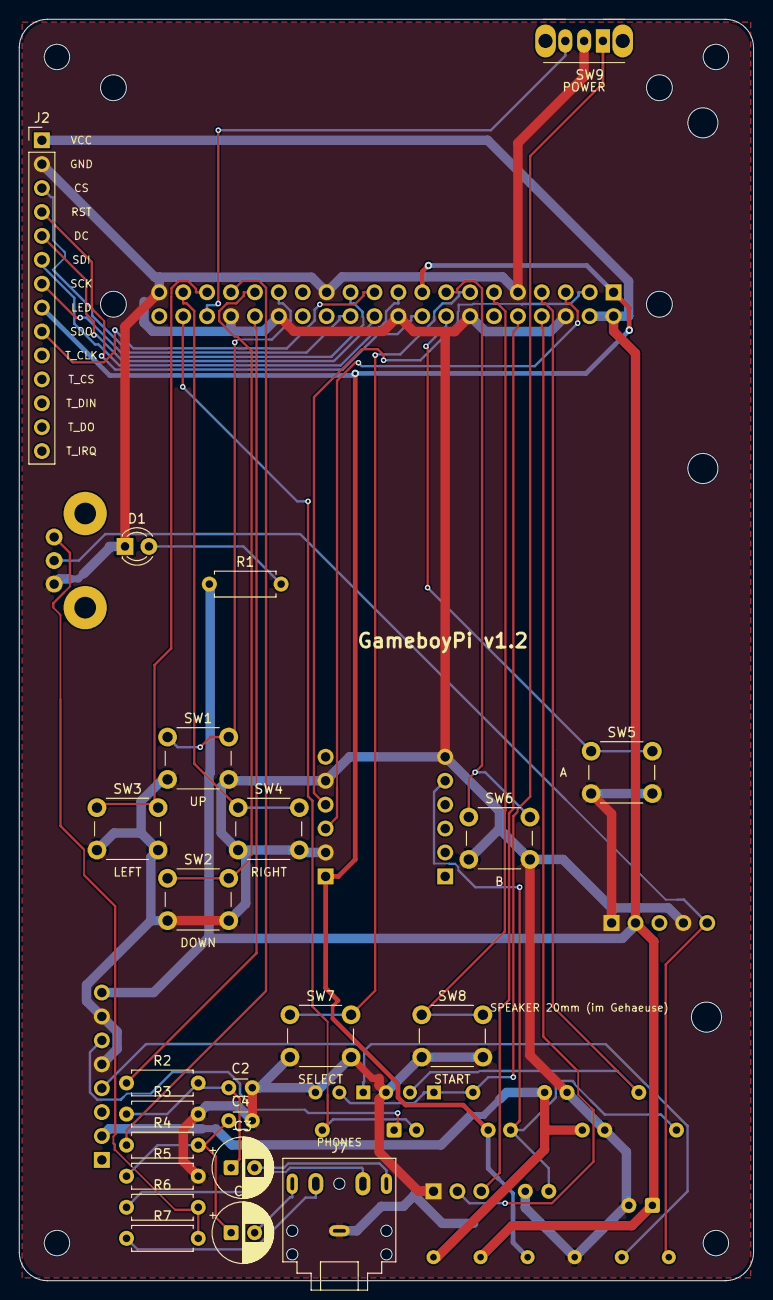
[picture p25: board GameboyPi.kicad_pcb from above]

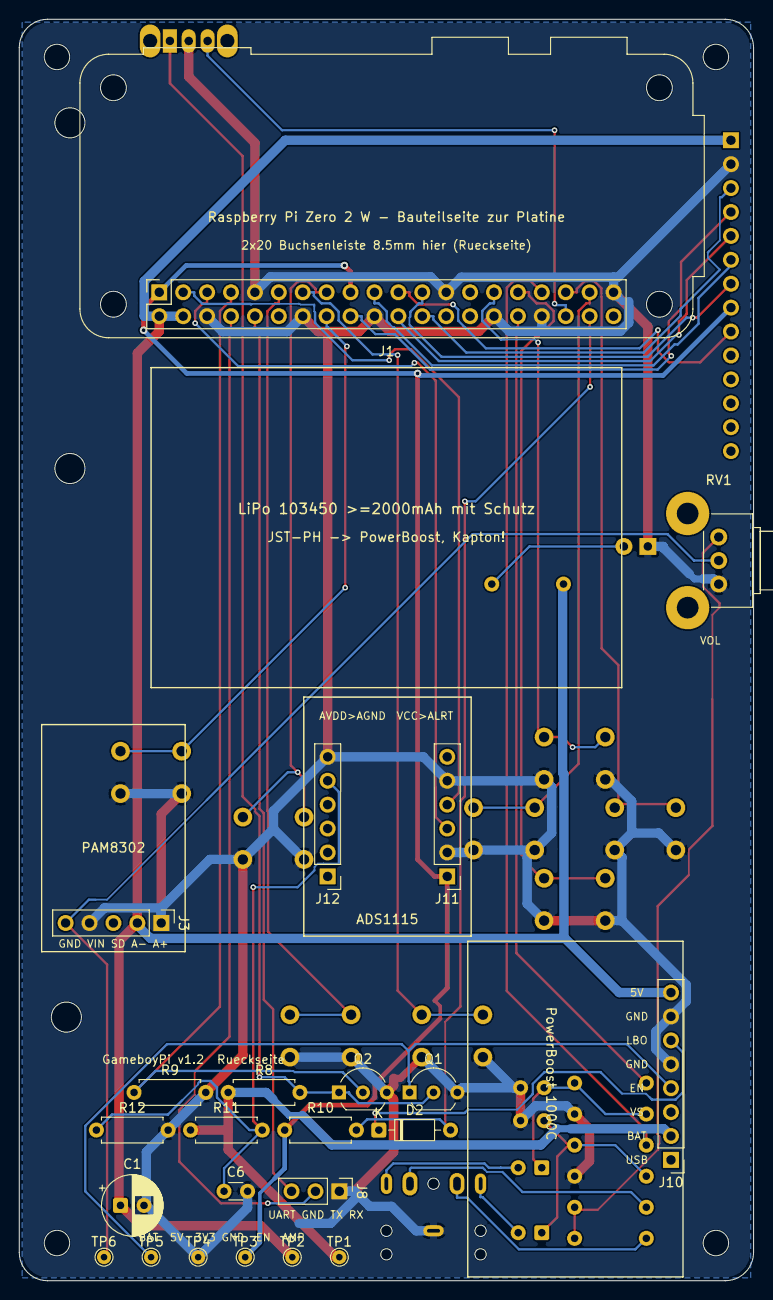
[picture p26: board GameboyPi.kicad_pcb from below]

Board: 2 copper layers, 78.0 x 134.0 mm, 53 parts (23 on the bottom side), 40 nets.
