EduCardBoden/GameboyPi/(commit log)

2026-10-29 Erster Stand GameboyPi
    [GameboyPi-B_Cu.gbl, GameboyPi-B_Mask.gbs, GameboyPi-B_Paste.gbp, GameboyPi-B_Silkscreen.gbo, GameboyPi-Edge_Cuts.gm1, GameboyPi-F_Cu.gtl, GameboyPi-F_Mask.gts, GameboyPi-F_Paste.gtp]
2026-10-29 Zeilenenden für Pi-Skripte und CAD-Dateien festlegen
    [ab.stl, back.stl, back_logo_purple.stl, back_logo_silver.stl, dpad.stl, front.stl, front_logo_purple.stl, front_logo_silver.stl]
2026-11-11 Build-Härtung, Doku-Abgleich Display, Claude-Setup
    - check_netlist.py bricht bei Abweichung von design.py ab (Exit 1)
    - route.py findet das neueste Microsoft-JDK >= 25 selbst (GAMEBOYPI_JAVA als Override)
    - build.ps1 (Platine/Gehäuse) aktualisieren bestellung/ und zeigen ERC/DRC-Zusammenfassung
    - README/BOM: bestelltes LAFVIN-Touch-Display (≈ MSP2402), Gehäuse 29,3 mm, ca. 130 €
    - testing.md: DRC-Zählung an aktuellen Bericht angepasst (105 Warnungen, 0 Fehler)
    - ARCHITECTURE.md, CLAUDE.md, Skills (design-change, pcb-build, case-build)
    und Hook gegen Handbearbeitung generierter Dateien
    [bill-of-materials.csv]
2026-11-11 GameboyPi v1.2: Grenzwertkorrekturen, Prüfwerkzeuge, Dokumentation
    Elektronik (design.py, neu geroutet, ERC 0/0, DRC 0 Fehler, 0 unverbunden):
    - R6/R7 10k -> 47k: Lautsprecher (0,5 W) wurde mit bis zu 1,4 W betrieben
    - R10 10k -> 100k: LBO des TPS61090 ist nur für 100 uA spezifiziert
    - Bestückungsdruck und Schaltplan-Schriftfeld auf v1.2
    Software:
    - battery_monitor.py: ADC-Lastkorrektur (6 MOhm), VBAT_CAL, LBO entprellt,
    GPIO20 ohne Pull, testbare Monitor-Klasse + 7 Unit-Tests
    - config.txt: gpio=20=ip,pn; install.sh robust und mehrfach ausführbar
    Werkzeuge: check_consistency.py (design.py <-> .scad <-> Pi-Software),
    stl_report.py, make_report.py + finalize_report.ps1 (Word-Bericht)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
    [GameboyPi-B_Cu.gbl, GameboyPi-B_Mask.gbs, GameboyPi-B_Paste.gbp, GameboyPi-B_Silkscreen.gbo, GameboyPi-Edge_Cuts.gm1, GameboyPi-F_Cu.gtl, GameboyPi-F_Mask.gts, GameboyPi-F_Paste.gtp]
2026-11-11 Werkzeuge installiert, Gehäuse-STEP über FreeCAD
    - installiert (winget): Python 3.13 (+python-docx, pypdf, pytest, fonttools),
    FreeCAD 1.1.4, ShellCheck 0.11.0 (install.sh: 0 Befunde), Poppler 25.07
    - tools/scad_to_step.py: STL -> gültige STEP-Volumenkörper (11/11, Volumen ±0,004 %),
    im Gehäuse-Build als Schritt 5; STEP-Dateien gitignored, step_report.txt versioniert
    - Hook schützt mechanical/step, VS-Code-Tasks für STEP und ShellCheck
    - Doku, Log und Word-Bericht nachgeführt
2026-11-11 Word-Bericht: Kompatibilitätsmodus 15 direkt im Generator setzen
    SaveAs2(CompatibilityMode=15) hatte den Modus nicht umgestellt; Log korrigiert.
    [make_report.py]
2026-11-11 Einkauf: 47k lieferbar (Stackpole), Warenkorb-Liste als Word
    - DigiKey-Warenkorb: 10k entfernt, 47k ergänzt (Yageo bis 03/2027 nicht lieferbar ->
    Stackpole CF14JT47K0, 10 Stk. 0,24 EUR); BOM, DigiKey-CSV, FINAL_BOM nachgezogen
    - tools/make_cart_list.py: Word-Liste der Warenkörbe mit Sammel-Links
    - Bericht-Kopie aus dem Projekt-Hauptordner entfernt (liegt in Dokumente/Emulator)
    [bill-of-materials.csv, digikey_mouser_bom.csv]
2026-11-13 Wegweiser: Generator, Vorlage und VS-Code-Task
